andrewb1999/Paraglider/images/Proto3-2.jpg

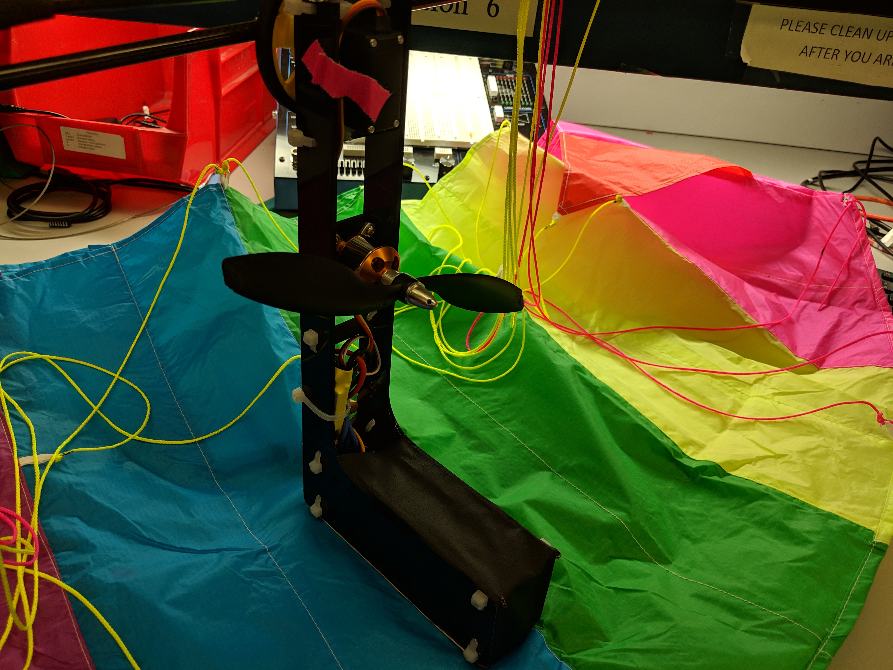
images/Proto3-2.jpg
