andrewb1999/Paraglider/(commit log)

2019-04-12 Working on PID
2019-04-27 Updated code for yaw stabilization
2019-04-30 Added Steering Code
2019-05-07 Uart to BeagleBone working
